DeMarco/DMH-S-H-Noise/README.md

# DMH-S-H-Noise

Implementation of the S&H + Noise Generator circuits by Moritz Klein into Kosmo format.
