DeMarco/DMH-S-H-Noise/DMH_S_H_Noise_PCB/DMH_S_H_Noise_PCB.kicad_pcb

## KiCad design DMH_S_H_Noise_PCB/DMH_S_H_Noise_PCB.kicad_pcb (2024-12-04)

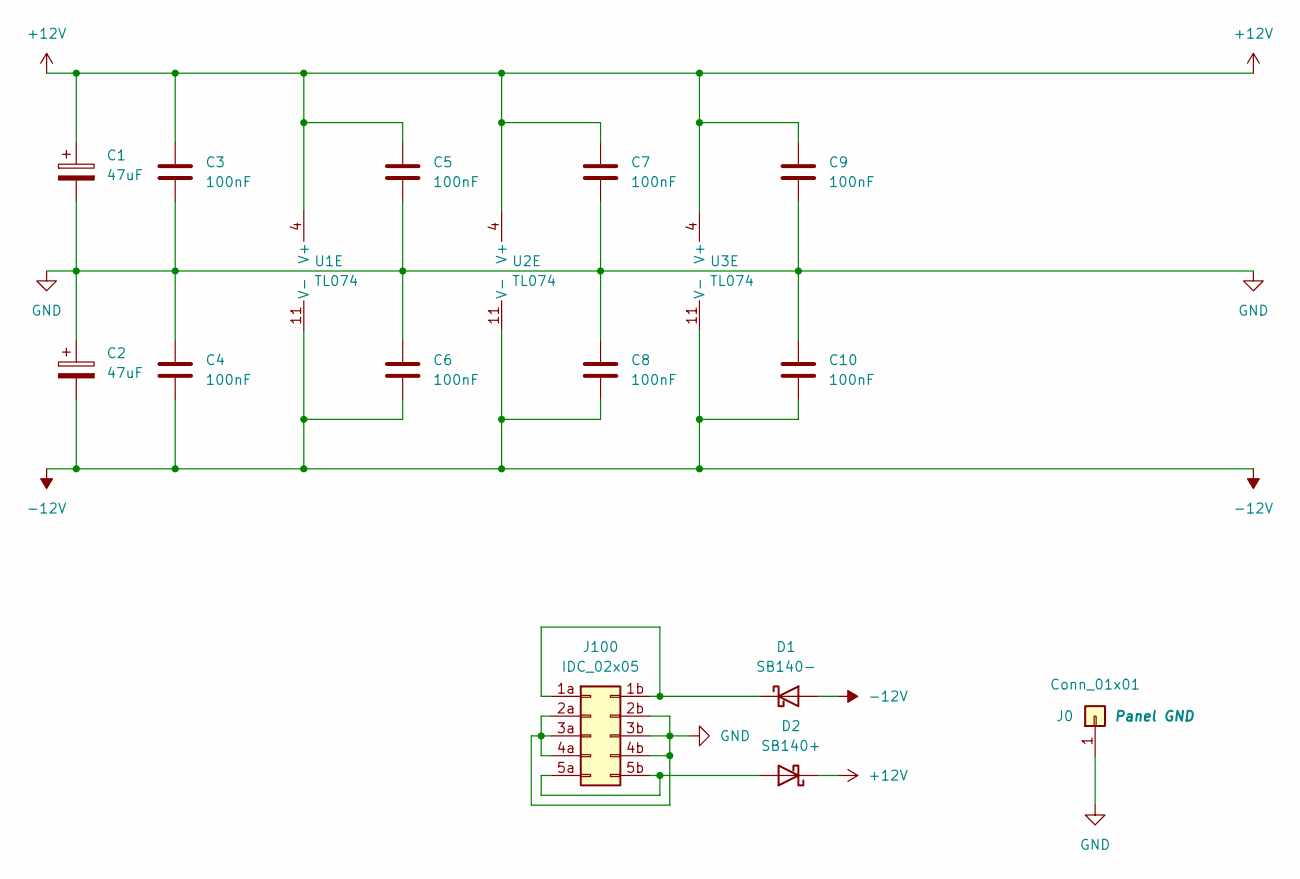
[picture p1: schematic Power.kicad_sch, Power Distribution]

Parts:
C1, C2: 47uF; CP_Radial_D5.0mm_P2.00mm
C3, C4, C5, C6, C7, C8, C9, C10: 100nF; C_Disc_D4.3mm_W1.9mm_P5.00mm
D1: SB140-; D_DO-41_SOD81_P10.16mm_Horizontal
D2: SB140+; D_DO-41_SOD81_P10.16mm_Horizontal
J0: Conn_01x01; PinHeader_1x01_P2.54mm_Vertical
J100: IDC_02x05; IDC-Header_2x05_P2.54mm_Vertical_Eurorack
U1, U2, U3: TL074; DIP-14_W7.62mm_Socket

Connections:
+12V: C1.1, C3.1, C5.1, C7.1, C9.1, D2.1 (K), U1.4 (V+), U2.4 (V+), U3.4 (V+); also elsewhere on the board
-12V: C2.2, C4.2, C6.2, C8.2, C10.2, D1.2 (A), U1.11 (V-), U2.11 (V-), U3.11 (V-)
GND: C1.2, C2.1, C3.2, C4.1, C5.2, C6.1, C7.2, C8.1, C9.2, C10.1, J0.1, J100.2a, J100.2b, J100.3a, J100.3b, J100.4a, J100.4b; also elsewhere on the board
unnamed: D1.1 (K), J100.1a, J100.1b
unnamed: D2.2 (A), J100.5a, J100.5b

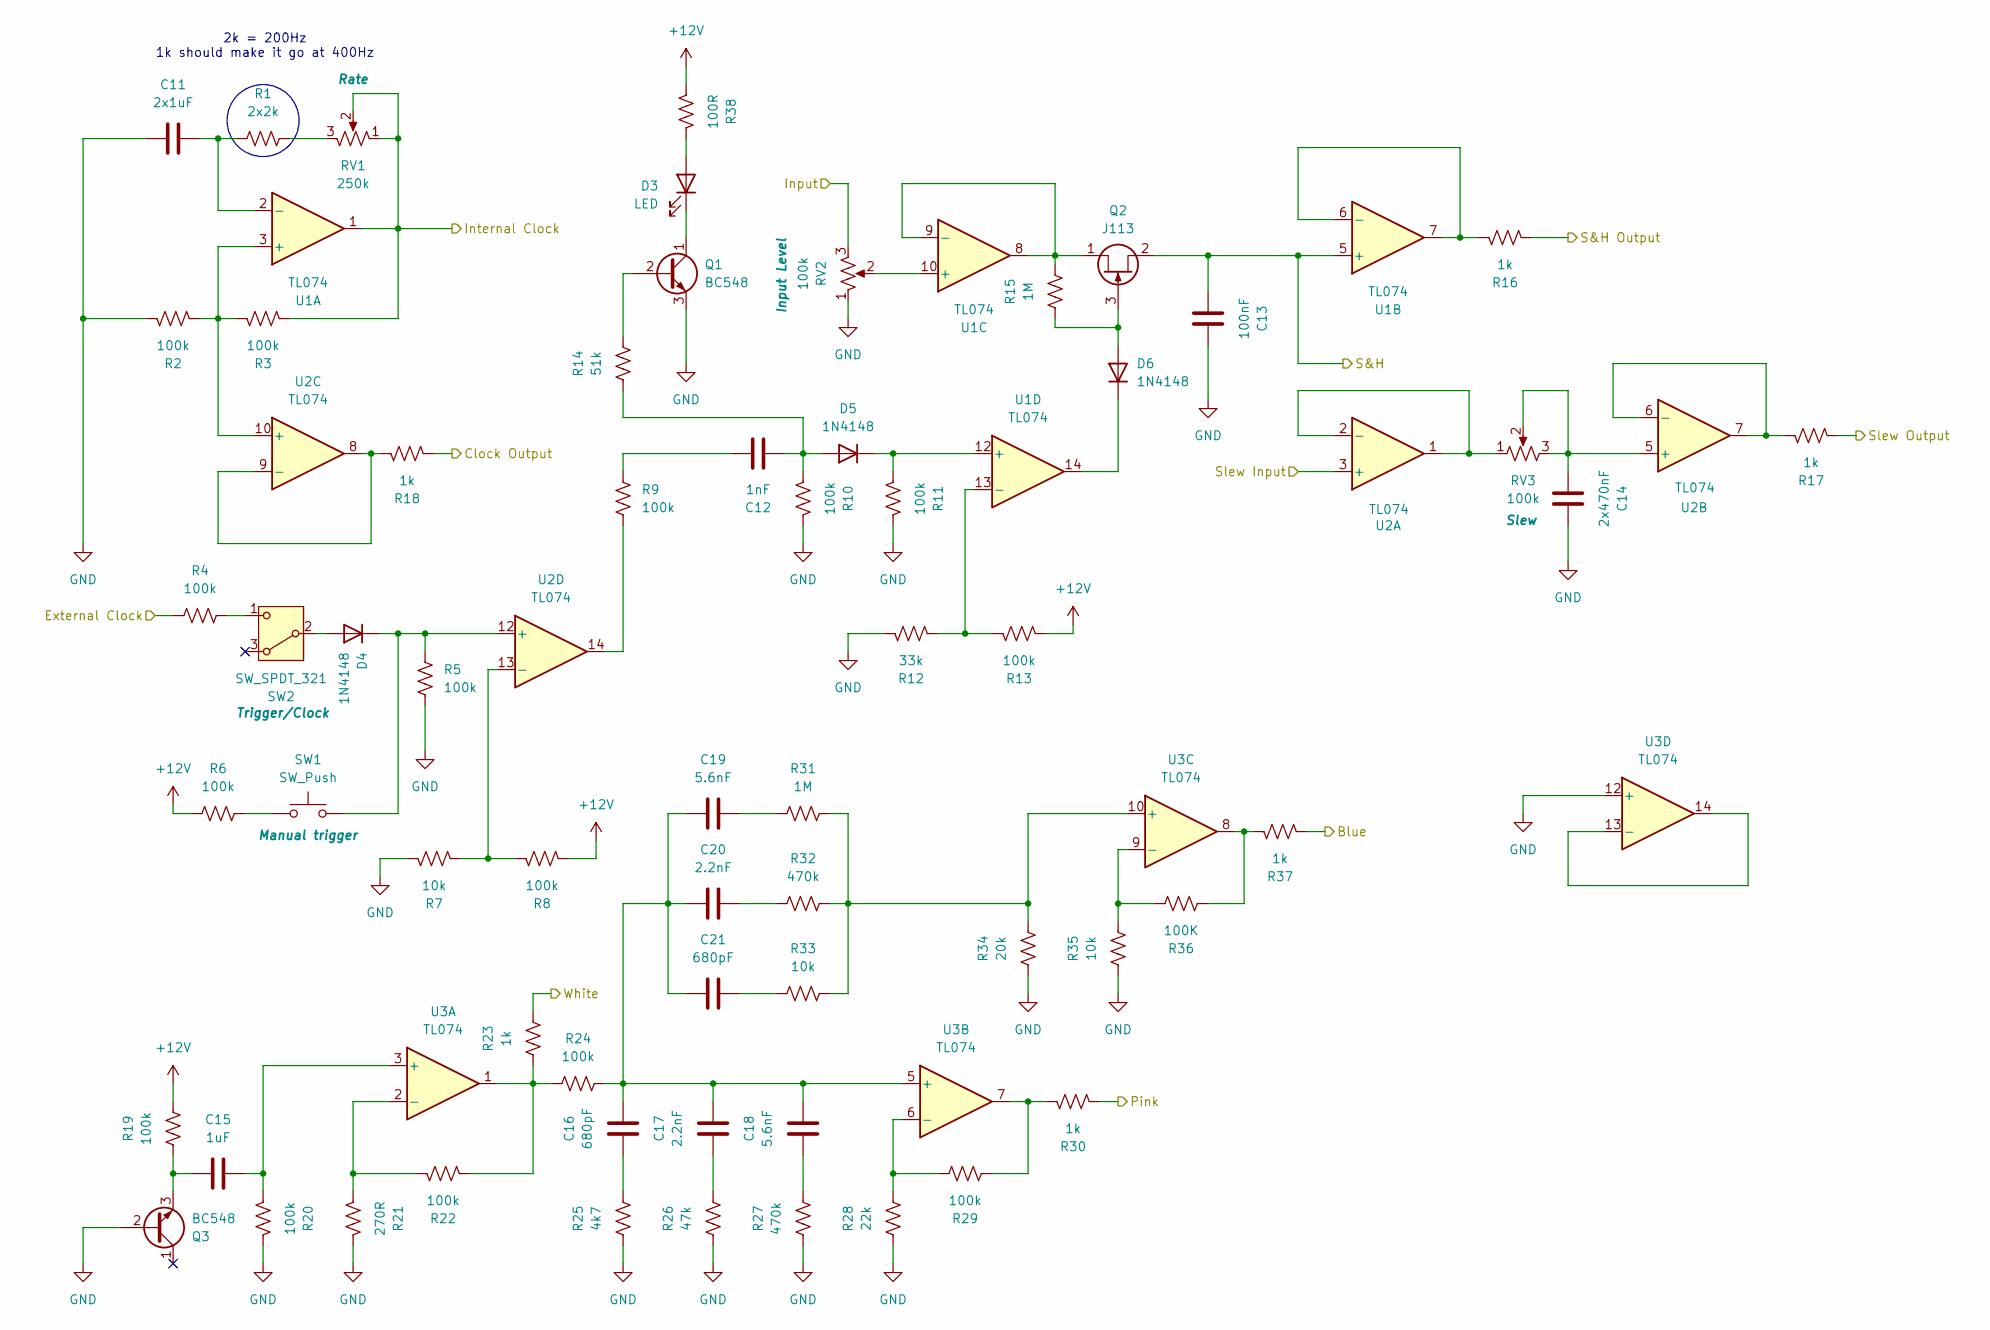
[picture p2: schematic Core_Circuit.kicad_sch]

Parts:
C11: 2x1uF; C_Disc_D4.3mm_W1.9mm_P5.00mm
C12: 1nF; C_Disc_D4.3mm_W1.9mm_P5.00mm
C13: 100nF; C_Disc_D4.3mm_W1.9mm_P5.00mm
C14: 2x470nF; C_Disc_D4.3mm_W1.9mm_P5.00mm
C15: 1uF; C_Disc_D4.3mm_W1.9mm_P5.00mm
C16, C21: 680pF; C_Disc_D4.3mm_W1.9mm_P5.00mm
C17, C20: 2.2nF; C_Disc_D4.3mm_W1.9mm_P5.00mm
C18, C19: 5.6nF; C_Disc_D4.3mm_W1.9mm_P5.00mm
D3: LED; LED_D3.0mm
D4, D5, D6: 1N4148; D_DO-35_SOD27_P7.62mm_Horizontal
Q1, Q3: BC548; TO-92_Inline_Wide
Q2: J113; TO-92L_Inline
R1: 2x2k; R_Axial_DIN0207_L6.3mm_D2.5mm_P7.62mm_Horizontal
R2, R3, R4, R5, R6, R8, R9, R10, R11, R13, R19, R20, R22, R24, R29: 100k; R_Axial_DIN0207_L6.3mm_D2.5mm_P7.62mm_Horizontal
R7, R33, R35: 10k; R_Axial_DIN0207_L6.3mm_D2.5mm_P7.62mm_Horizontal
R12: 33k; R_Axial_DIN0207_L6.3mm_D2.5mm_P7.62mm_Horizontal
R14: 51k; R_Axial_DIN0207_L6.3mm_D2.5mm_P7.62mm_Horizontal
R15, R31: 1M; R_Axial_DIN0207_L6.3mm_D2.5mm_P7.62mm_Horizontal
R16, R17, R18, R23, R30, R37: 1k; R_Axial_DIN0207_L6.3mm_D2.5mm_P7.62mm_Horizontal
R21: 270R; R_Axial_DIN0207_L6.3mm_D2.5mm_P7.62mm_Horizontal
R25: 4k7; R_Axial_DIN0207_L6.3mm_D2.5mm_P7.62mm_Horizontal
R26: 47k; R_Axial_DIN0207_L6.3mm_D2.5mm_P7.62mm_Horizontal
R27, R32: 470k; R_Axial_DIN0207_L6.3mm_D2.5mm_P7.62mm_Horizontal
R28: 22k; R_Axial_DIN0207_L6.3mm_D2.5mm_P7.62mm_Horizontal
R34: 20k; R_Axial_DIN0207_L6.3mm_D2.5mm_P7.62mm_Horizontal
R36: 100K; R_Axial_DIN0207_L6.3mm_D2.5mm_P7.62mm_Horizontal
R38: 100R; R_Axial_DIN0207_L6.3mm_D2.5mm_P7.62mm_Horizontal
RV1: 250k; Potentiometer_Alpha_RD901F-40-00D_Single_Vertical
RV2, RV3: 100k; Potentiometer_Alpha_RD901F-40-00D_Single_Vertical
SW1: SW_Push; SW_Cherry_MX_1.00u_PCB
SW2: SW_SPDT_321; Toggle_Switch_THT
U1, U2, U3: TL074; DIP-14_W7.62mm_Socket

Connections:
+12V: R6.2, R8.1, R13.1, R19.1, R38.1; also elsewhere on the board
/Core Circuit/Blue: R37.1; also elsewhere on the board
/Core Circuit/Clock Output: R18.1; also elsewhere on the board
/Core Circuit/External Clock: R4.2; also elsewhere on the board
/Core Circuit/Input: RV2.3; also elsewhere on the board
/Core Circuit/Internal Clock: R3.1, RV1.1, RV1.2, U1.1; also elsewhere on the board
/Core Circuit/Pink: R30.1; also elsewhere on the board
/Core Circuit/S&H: C13.1, Q2.2 (S), U1.5 (+); also elsewhere on the board
/Core Circuit/S&H Output: R16.1; also elsewhere on the board
/Core Circuit/Slew Input: U2.3 (+); also elsewhere on the board
/Core Circuit/Slew Output: R17.1; also elsewhere on the board
/Core Circuit/White: R23.1; also elsewhere on the board
GND: C11.1, C13.2, C14.2, Q1.3 (E), Q3.2 (B), R2.2, R5.1, R7.2, R10.2, R11.2, R12.2, R20.2, R21.2, R25.2, R26.2, R27.2, R28.2, R34.2, R35.2, RV2.1, U3.12 (+); also elsewhere on the board
unnamed: C12.2, R9.2
unnamed: C16.2, R25.1
unnamed: C17.2, R26.1
unnamed: C18.2, R27.1
unnamed: C19.2, R31.2
unnamed: C20.2, R32.2
unnamed: C21.2, R33.2
unnamed: D3.2 (A), R38.2
unnamed: D3.1 (K), Q1.1 (C)
unnamed: D4.2 (A), SW2.2 (B)
unnamed: D4.1 (K), R5.2, SW1.2, U2.12 (+)
unnamed: C12.1, D5.2 (A), R10.1, R14.2
unnamed: D5.1 (K), R11.1, U1.12 (+)
unnamed: D6.2 (A), Q2.3 (G), R15.2
unnamed: D6.1 (K), U1.14
unnamed: Q1.2 (B), R14.1
unnamed: Q2.1 (D), R15.1, U1.8, U1.9 (-)
unnamed: C15.1, Q3.3 (E), R19.2
unnamed: R1.1, RV1.3
unnamed: R6.1, SW1.1
unnamed: R9.1, U2.14
unnamed: R22.1, R23.2, R24.2, U3.1
unnamed: R29.2, R30.2, U3.7
unnamed: R36.2, R37.2, U3.8
unnamed: R4.1, SW2.1 (C)
unnamed: R2.1, R3.2, U1.3 (+), U2.10 (+)
unnamed: C11.2, R1.2, U1.2 (-)
unnamed: R16.2, U1.6 (-), U1.7
unnamed: RV2.2, U1.10 (+)
unnamed: R12.1, R13.2, U1.13 (-)
unnamed: RV3.1, U2.1, U2.2 (-)
unnamed: C14.1, RV3.2, RV3.3, U2.5 (+)
unnamed: R17.2, U2.6 (-), U2.7
unnamed: R18.2, U2.8, U2.9 (-)
unnamed: R7.1, R8.2, U2.13 (-)
unnamed: C15.2, R20.1, U3.3 (+)
unnamed: R21.1, R22.2, U3.2 (-)
unnamed: C16.1, C17.1, C18.1, C19.1, C20.1, C21.1, R24.1, U3.5 (+)
unnamed: R28.1, R29.1, U3.6 (-)
unnamed: R31.1, R32.1, R33.1, R34.1, U3.10 (+)
unnamed: R35.1, R36.1, U3.9 (-)
unnamed: U3.13 (-), U3.14

Notes on the sheet:
2k = 200Hz 1k should make it go at 400Hz

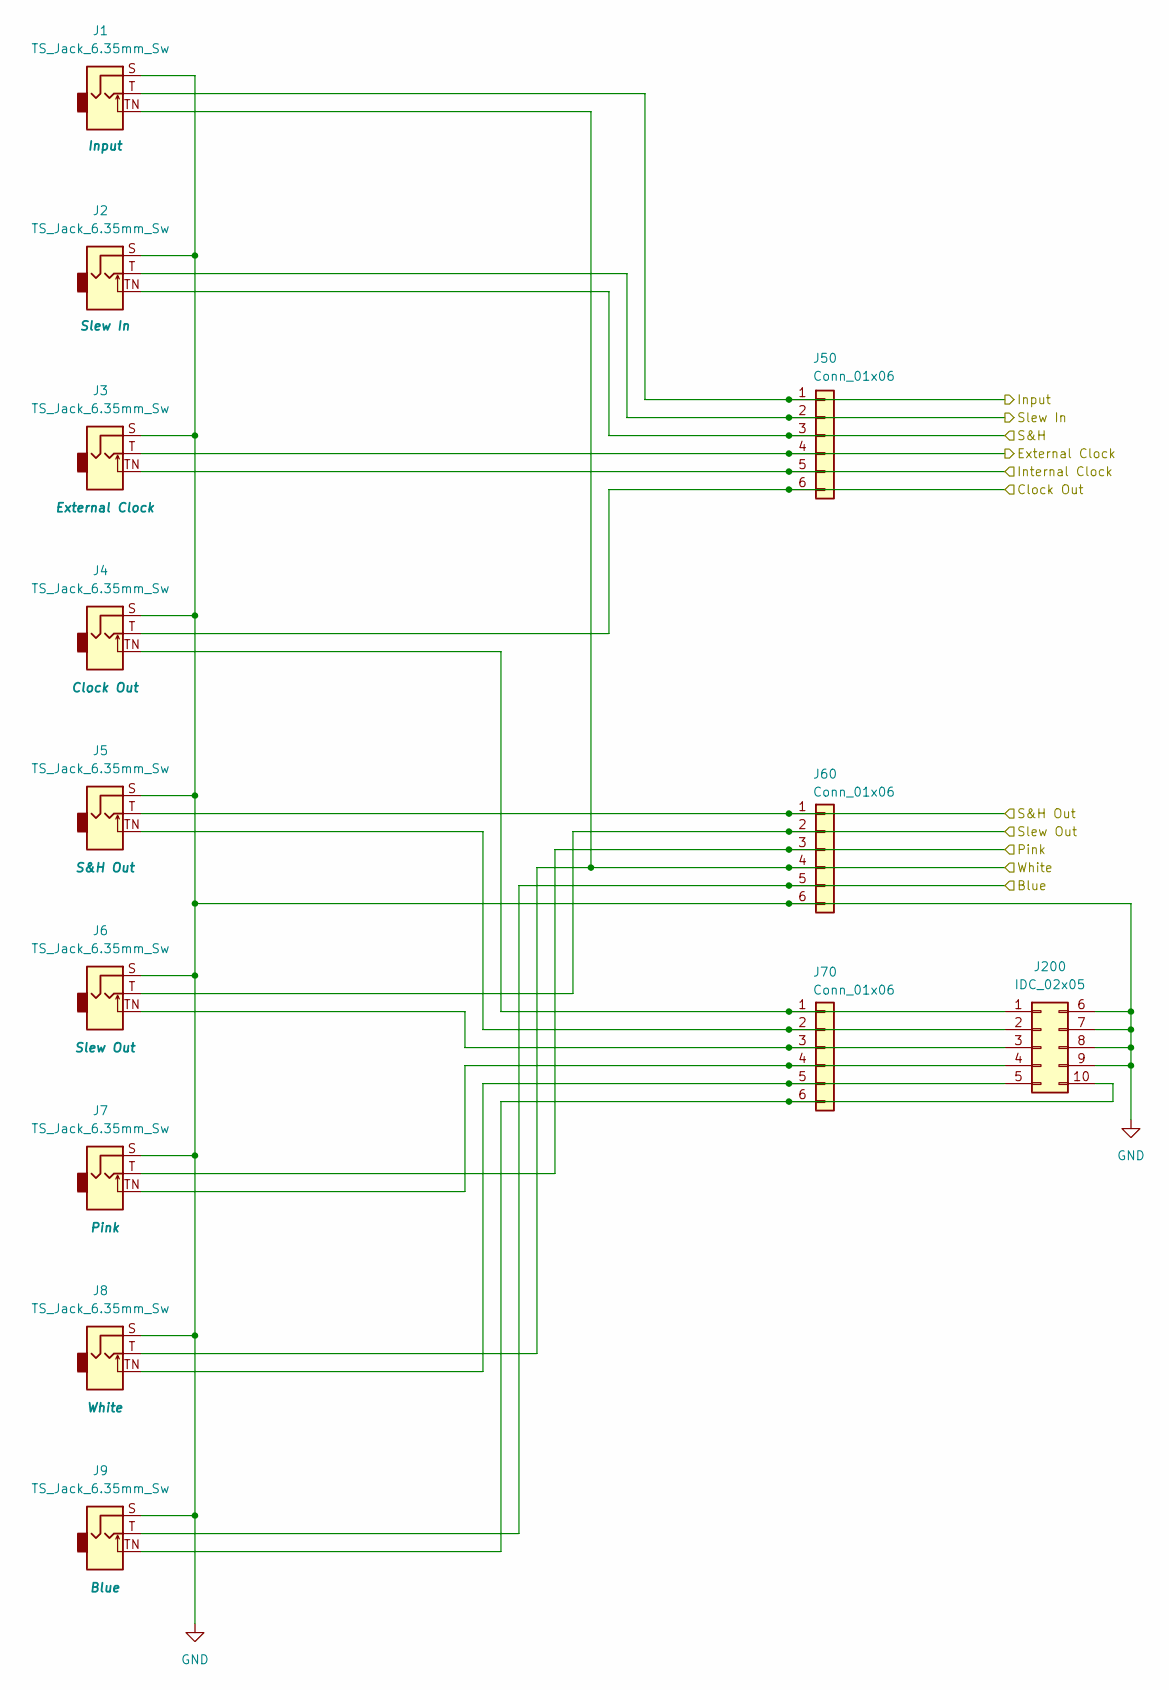
[picture p3: schematic Inputs_and_Outputs.kicad_sch]

Parts:
J1, J2, J3, J4, J5, J6, J7, J8, J9: TS_Jack_6.35mm_Sw; CUI_MJ-63052A
J50, J60, J70: Conn_01x06; PinSocket_1x06_P2.54mm_Vertical
J200: IDC_02x05; IDC-Header_2x05_P2.54mm_Vertical_BackBone

Connections:
/Core Circuit/Blue: J9.T, J60.5; also elsewhere on the board
/Core Circuit/Clock Output: J4.T, J50.6; also elsewhere on the board
/Core Circuit/External Clock: J3.T, J50.4; also elsewhere on the board
/Core Circuit/Input: J1.T, J50.1; also elsewhere on the board
/Core Circuit/Internal Clock: J3.TN, J50.5; also elsewhere on the board
/Core Circuit/Pink: J7.T, J60.3; also elsewhere on the board
/Core Circuit/S&H: J2.TN, J50.3; also elsewhere on the board
/Core Circuit/S&H Output: J5.T, J60.1; also elsewhere on the board
/Core Circuit/Slew Input: J2.T, J50.2; also elsewhere on the board
/Core Circuit/Slew Output: J6.T, J60.2; also elsewhere on the board
/Core Circuit/White: J1.TN, J8.T, J60.4; also elsewhere on the board
GND: J1.S, J2.S, J3.S, J4.S, J5.S, J6.S, J7.S, J8.S, J9.S, J60.6, J200.6, J200.7, J200.8, J200.9; also elsewhere on the board
unnamed: J4.TN, J70.1, J200.1
unnamed: J5.TN, J70.2, J200.2
unnamed: J6.TN, J70.3, J200.3
unnamed: J7.TN, J70.4, J200.4
unnamed: J8.TN, J70.5, J200.5
unnamed: J9.TN, J70.6, J200.10

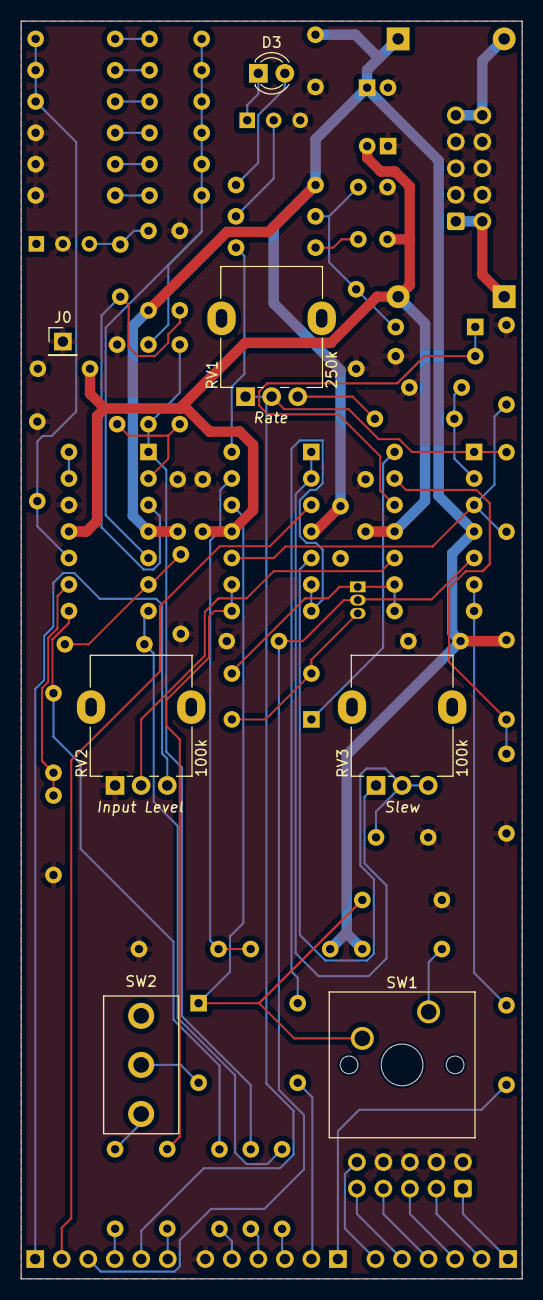
[picture p4: board DMH_S_H_Noise_PCB.kicad_pcb from above]

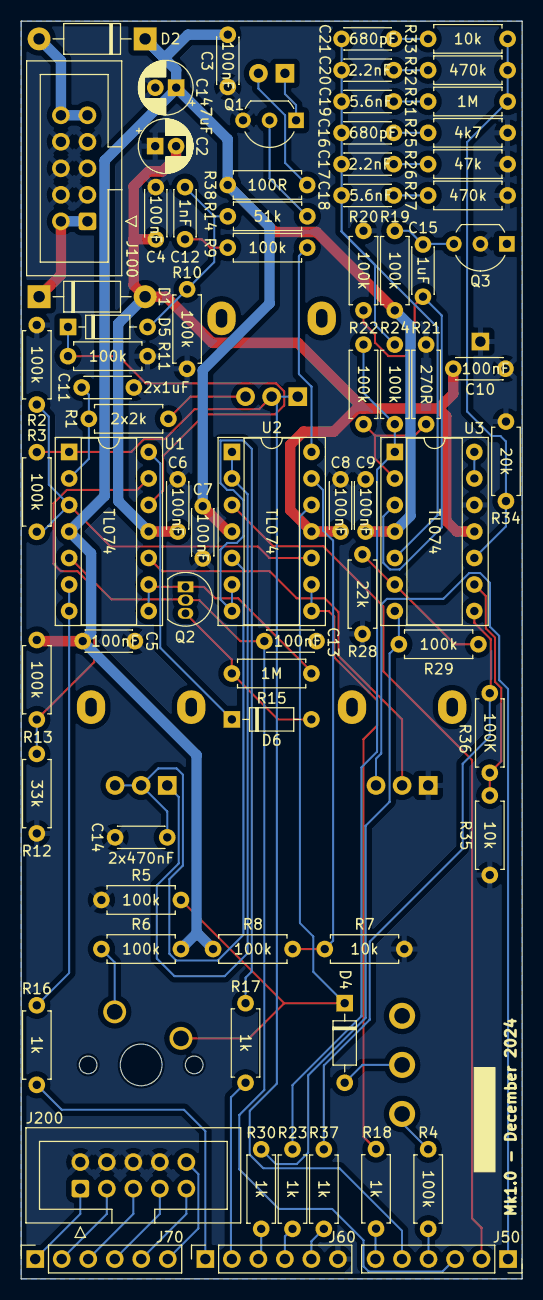
[picture p5: board DMH_S_H_Noise_PCB.kicad_pcb from below]

Board: 2 copper layers, 48.0 x 120.5 mm, 82 parts (75 on the bottom side), 64 nets.
