DeMarco/DMH-S-H-Noise/DMH_S_H_Noise_PCB_Conn/DMH_S_H_Noise_PCB_Conn.kicad_pcb

## KiCad design DMH_S_H_Noise_PCB_Conn/DMH_S_H_Noise_PCB_Conn.kicad_pcb (2024-12-04)

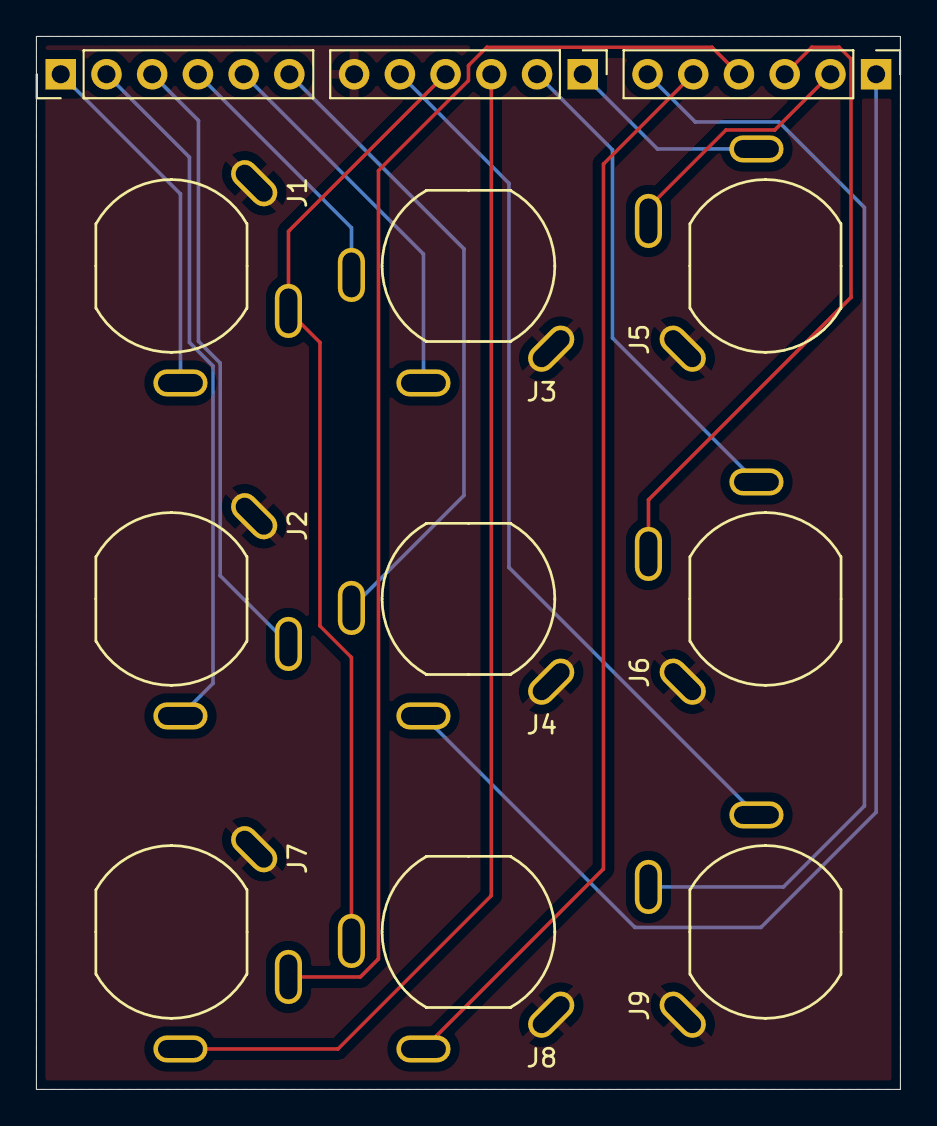
[picture p6: board DMH_S_H_Noise_PCB_Conn.kicad_pcb from above]

Board: 2 copper layers, 48.0 x 58.5 mm, 12 parts (0 on the bottom side), 18 nets.

Parts:
J1, J2, J3, J4, J5, J6, J7, J8, J9: TS_Jack_6.35mm_Sw; CUI_MJ-63052A
J50, J60, J70: Conn_01x06; PinHeader_1x06_P2.54mm_Vertical

Connections:
/Inputs and Outputs/Blue: J9.T, J60.5
/Inputs and Outputs/Clock Out: J4.T, J50.6
/Inputs and Outputs/External Clock: J3.T, J50.4
/Inputs and Outputs/Input: J1.T, J50.1
/Inputs and Outputs/Internal Clock: J3.TN, J50.5
/Inputs and Outputs/Pink: J7.T, J60.3
/Inputs and Outputs/S&H: J2.TN, J50.3
/Inputs and Outputs/S&H Out: J5.T, J60.1
/Inputs and Outputs/Slew In: J2.T, J50.2
/Inputs and Outputs/Slew Out: J6.T, J60.2
/Inputs and Outputs/White: J1.TN, J8.T, J60.4
GND: J1.S, J2.S, J3.S, J4.S, J5.S, J6.S, J7.S, J8.S, J9.S, J60.6
unnamed: J4.TN, J70.1
unnamed: J5.TN, J70.2
unnamed: J6.TN, J70.3
unnamed: J7.TN, J70.4
unnamed: J8.TN, J70.5
unnamed: J9.TN, J70.6
