DeMarco/DMH-S-H-Noise/(commit log)

2024-11-01 Prepared KiCad projects
    [Core_Circuit.kicad_sch, DMH_S_H_Noise_PANEL.kicad_pcb, DMH_S_H_Noise_PANEL.kicad_sch, DMH_S_H_Noise_PCB.kicad_pcb, DMH_S_H_Noise_PCB.kicad_sch, DMH_S_H_Noise_PCB_Conn.kicad_pcb, DMH_S_H_Noise_PCB_Conn.kicad_sch, Inputs_and_Outputs.kicad_sch]
2024-11-01 Created front panel
    [DMH_S_H_Noise_PANEL.kicad_pcb, DMH_S_H_Noise_PANEL.kicad_sch]
2024-11-01 Started schematic
    [Core_Circuit.kicad_sch, DMH_S_H_Noise_PCB.kicad_sch, Power.kicad_sch]
2024-11-02 Designed S&h circuit
    [Core_Circuit.kicad_sch, Power.kicad_sch]
2024-11-03 Completed circuit
    [Core_Circuit.kicad_sch, DMH_S_H_Noise_PANEL.kicad_pcb, DMH_S_H_Noise_PANEL.kicad_sch, DMH_S_H_Noise_PCB.kicad_sch, Power.kicad_sch]
2024-11-03 Corrections during breadboard assembly
    [Core_Circuit.kicad_sch, Power.kicad_sch]
2024-11-05 Updated resistor values after test
    [Core_Circuit.kicad_sch]
2024-11-08 Added Rate LED to the panel
    [DMH_S_H_Noise_PANEL.kicad_pcb, DMH_S_H_Noise_PANEL.kicad_sch]
2024-11-08 Manual trigger panel experiments ongoing
    [DMH_S_H_Noise_PANEL.kicad_pcb, DMH_S_H_Noise_PANEL.kicad_sch]
2024-11-09 Added toggle switch for trigger source
    [DMH_S_H_Noise_PANEL.kicad_pcb]
2024-11-09 Finished front panel
    [DMH_S_H_Noise_PANEL.kicad_pcb, DMH_S_H_Noise_PANEL.kicad_sch]
2024-11-10 Finished schematic
    [Core_Circuit.kicad_sch, DMH_S_H_Noise_PCB.kicad_sch, Inputs_and_Outputs.kicad_sch]
2024-11-10 Added toggle switch to schematic
    [Core_Circuit.kicad_sch]
2024-11-12 Added clock output
    [Core_Circuit.kicad_sch, DMH_S_H_Noise_PANEL.kicad_pcb, DMH_S_H_Noise_PANEL.kicad_sch, DMH_S_H_Noise_PCB.kicad_sch, Inputs_and_Outputs.kicad_sch, Power.kicad_sch]
2024-11-14 Component placement ongoing
    [Core_Circuit.kicad_sch, DMH_S_H_Noise_PANEL.kicad_pcb, DMH_S_H_Noise_PCB.kicad_pcb, Inputs_and_Outputs.kicad_sch]
2024-11-15 Finished placement and initial routing
    [DMH_S_H_Noise_PCB.kicad_pcb, Inputs_and_Outputs.kicad_sch]
2024-11-17 Restarted positioning from scratch
    [Core_Circuit.kicad_sch, DMH_S_H_Noise_PCB.kicad_pcb, Power.kicad_sch]
2024-11-17 Minor positioning corrections
    [Core_Circuit.kicad_sch, DMH_S_H_Noise_PCB.kicad_pcb]
2024-11-17 Rerouting finished
    [DMH_S_H_Noise_PCB.kicad_pcb]
2024-11-18 Minor corrections
    [Core_Circuit.kicad_sch, DMH_S_H_Noise_PCB.kicad_pcb]
2024-11-18 Finished connectors PCB
    [DMH_S_H_Noise_PCB.kicad_pcb, DMH_S_H_Noise_PCB_Conn.kicad_pcb, DMH_S_H_Noise_PCB_Conn.kicad_sch, Inputs_and_Outputs.kicad_sch, Power.kicad_sch]
2024-12-04 Generated Gerbers
    [DMH_S_H_Noise_PANEL-B_Cu.gbl, DMH_S_H_Noise_PANEL-B_Mask.gbs, DMH_S_H_Noise_PANEL-B_Paste.gbp, DMH_S_H_Noise_PANEL-B_Silkscreen.gbo, DMH_S_H_Noise_PANEL-Edge_Cuts.gm1, DMH_S_H_Noise_PANEL-F_Cu.gtl, DMH_S_H_Noise_PANEL-F_Mask.gts, DMH_S_H_Noise_PANEL-F_Paste.gtp]
2024-12-08 Generated BoM
    [DMH_S_H_Noise_PANEL.kicad_sch]
2025-05-07 Exported BoM
    [DMH_S_H_Noise_PANEL_BoM.csv, DMH_S_H_Noise_PCB_BoM.csv]
2025-08-01 Uploaded BoM
